baoshi/ESP-Breakout/doc/ESP-Breakout2.jpg

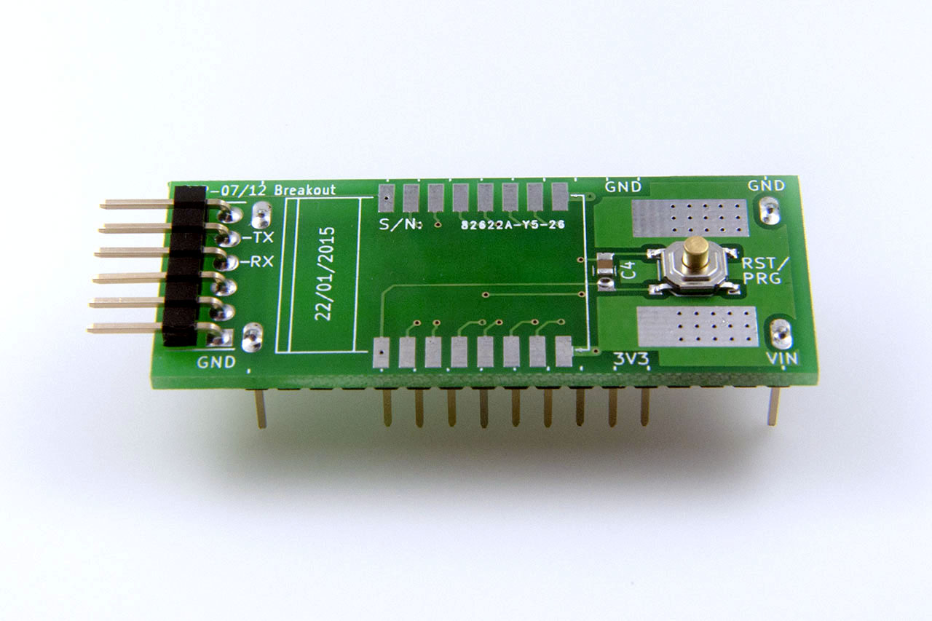
doc/ESP-Breakout2.jpg
