baoshi/ESP-Breakout/doc/ESP-Breakout.png

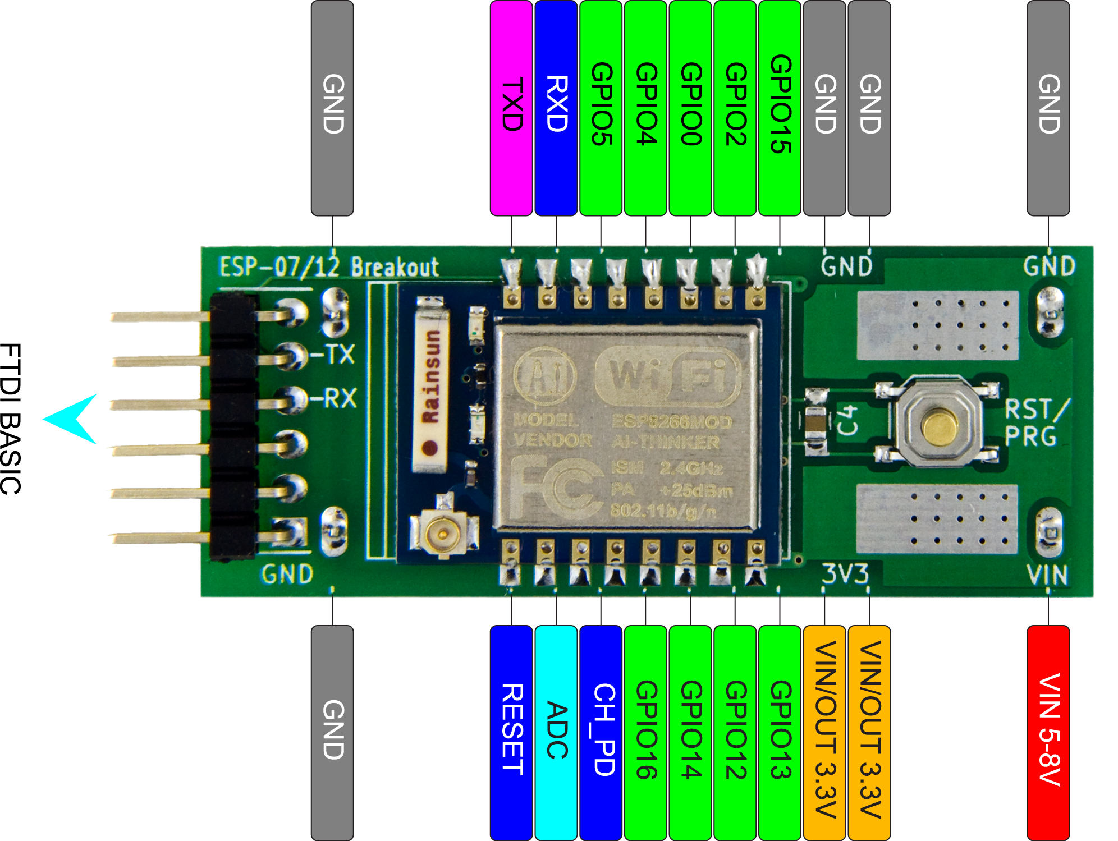
doc/ESP-Breakout.png
