baoshi/ESP-Breakout/readme.md

#ESP-Breakout

Breadboard adapter for ESP-07 and ESP-12 full I/O ESP8266 module

Licensed under CC-0, available at http://creativecommons.org/publicdomain/zero/1.0/
