baoshi/ESP-Breakout/doc/ESP-Breakout1.jpg

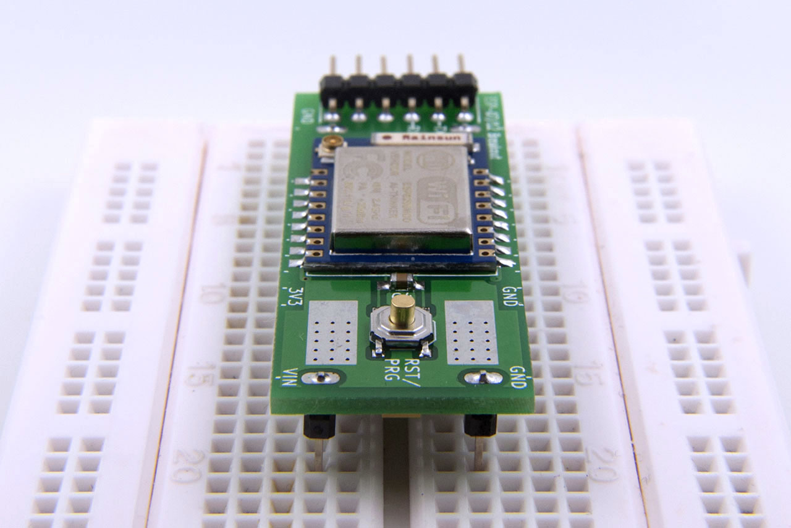
doc/ESP-Breakout1.jpg
