baoshi/ESP-Breakout/doc/ESP-Breakout3.jpg

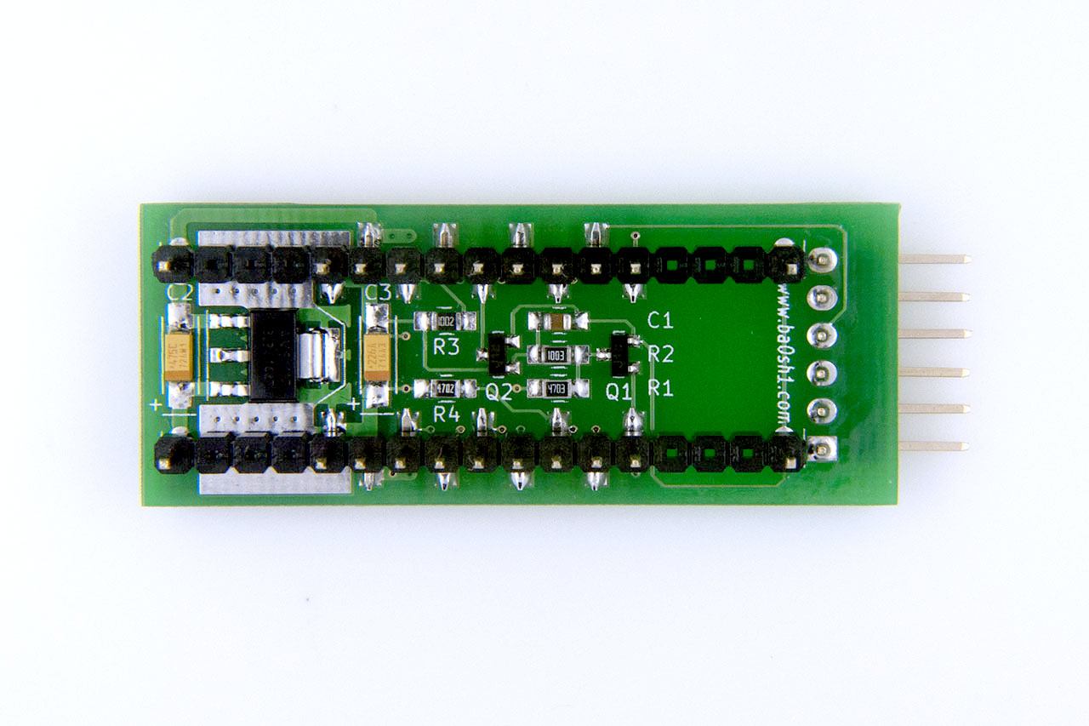
doc/ESP-Breakout3.jpg
