baoshi/ESP-Breakout/hw/ESP-Breakout.pdf

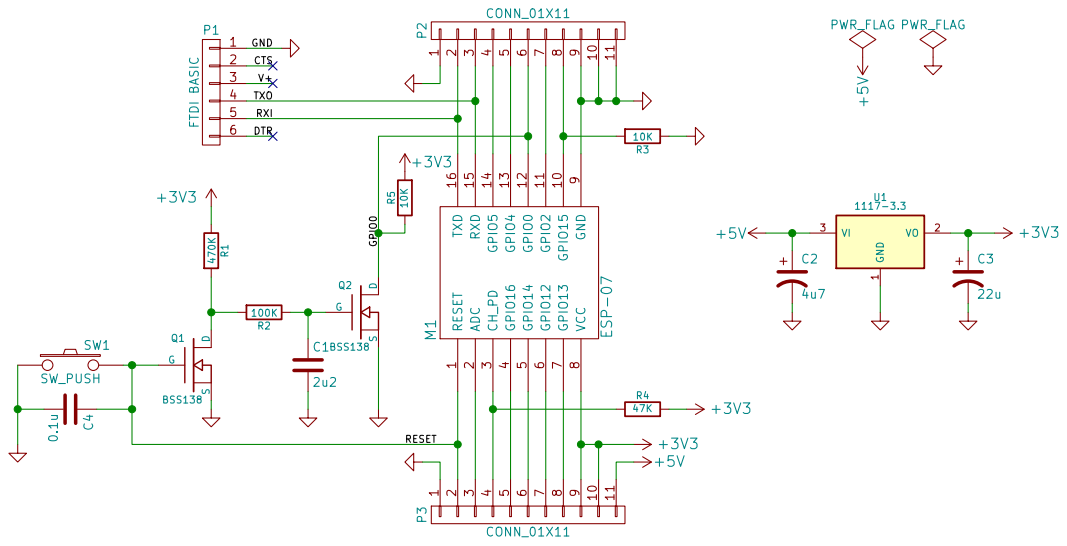
[picture p12: page 1]
