baoshi/ESP-Breakout/hw/ESP-Breakout.kicad_pcb

## KiCad design hw/ESP-Breakout.kicad_pcb (2015-08-20)

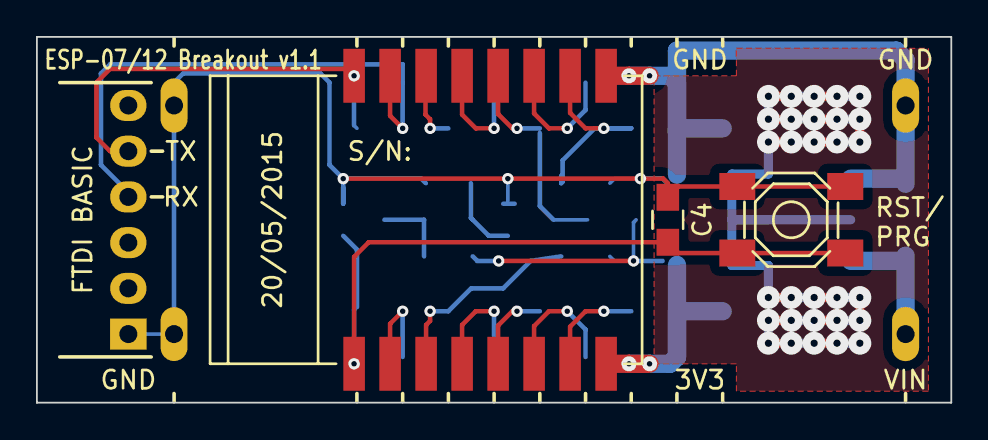
[picture p13: board ESP-Breakout.kicad_pcb from above]

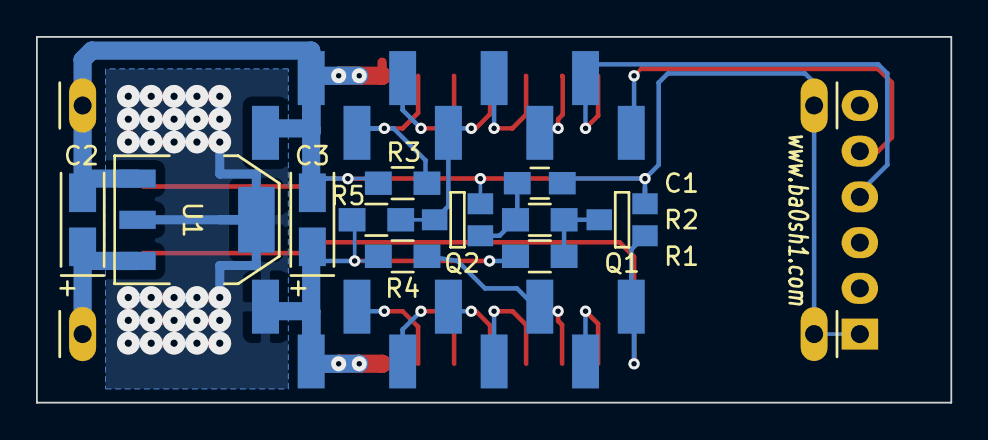
[picture p14: board ESP-Breakout.kicad_pcb from below]

Board: 2 copper layers, 50.8 x 20.3 mm, 17 parts (13 on the bottom side), 19 nets.

Parts:
C1: 2u2; C_0805_HandSoldering
C2: 4u7; TantalC_SizeA_EIA-3216_Wave
C3: 22u; TantalC_SizeA_EIA-3216_Wave
C4: 0.1u; C_0805_HandSoldering
M1: ESP-07
P1: FTDI BASIC; Pin_Header_Angled_1x06
P2: CONN_01X11; SMD-PINHEADER-11A
P3: CONN_01X11; SMD-PINHEADER-11B
Q1, Q2: BSS138; SOT-23-GDS
R1: 470K; R_0805_HandSoldering
R2: 100K; R_0805_HandSoldering
R3, R5: 10K; R_0805_HandSoldering
R4: 47K; R_0805_HandSoldering
SW1: SW_PUSH; PUSH_4x4_SMD
U1: 1117-3.3; SOT-223

Connections:
+3V3: C3.1, M1.8, P3.9, P3.10, R1.1, R4.2, R5.2, U1.2
+5V: C2.1, P3.11, U1.3
/GPIO0: M1.12, P2.6, Q2.D, R5.1
/RESET: C4.1, M1.1, P3.2, Q1.G, SW1.2
/RXI: M1.16, P1.5, P2.2
/TXO: M1.15, P1.4, P2.3
GND: C1.2, C2.2, C3.2, C4.2, M1.9, P1.1, P2.1, P2.9, P2.10, P2.11, P3.1, Q1.S, Q2.S, R3.1, SW1.1, U1.1
unnamed: C1.1, Q2.G, R2.1
unnamed: M1.2, P3.3
unnamed: M1.3, P3.4, R4.1
unnamed: M1.4, P3.5
unnamed: M1.5, P3.6
unnamed: M1.6, P3.7
unnamed: M1.7, P3.8
unnamed: M1.10, P2.8, R3.2
unnamed: M1.11, P2.7
unnamed: M1.13, P2.5
unnamed: M1.14, P2.4
unnamed: Q1.D, R1.2, R2.2
