baoshi/ESP-Breakout/(threads)

Thread 2 (2023-03-05):

Upgrade to KiCad V7

maovidal, 2023-03-05:
Hi @baoshi:

Are you interested in upgrading this project to KiCad V7?
I have done the manual pairing of the schematic symbols on this branch: https://github.com/maovidal/ESP-Breakout/tree/Converted-to-KiCad7

BTW, thank you for sharing your work. This is a neat PCB.
