baoshi/ESP-Breakout/(commit log)

2015-02-15 Footprint change
    Footprint change to facilitate hand soldering
    [ESP-Breakout.kicad_pcb]
2015-03-28 Minor footprint change to Tantalum caps
    [ESP-Breakout.kicad_pcb, ESP-Breakout.sch]
2015-08-20 V1.1
    Added a pull-up resistor on GPIO0 pin
    [ESP-Breakout.kicad_pcb, ESP-Breakout.sch]
